joshajohnson/digital-explorer/README.md

Digital explorer board for common embedded protocols (UART, I2C, SPI, WS2812).

More info here: https://joshajohnson.com/digital-explorer-board/
