joshajohnson/digital-explorer/hardware/0.1/demo_pcb.pdf

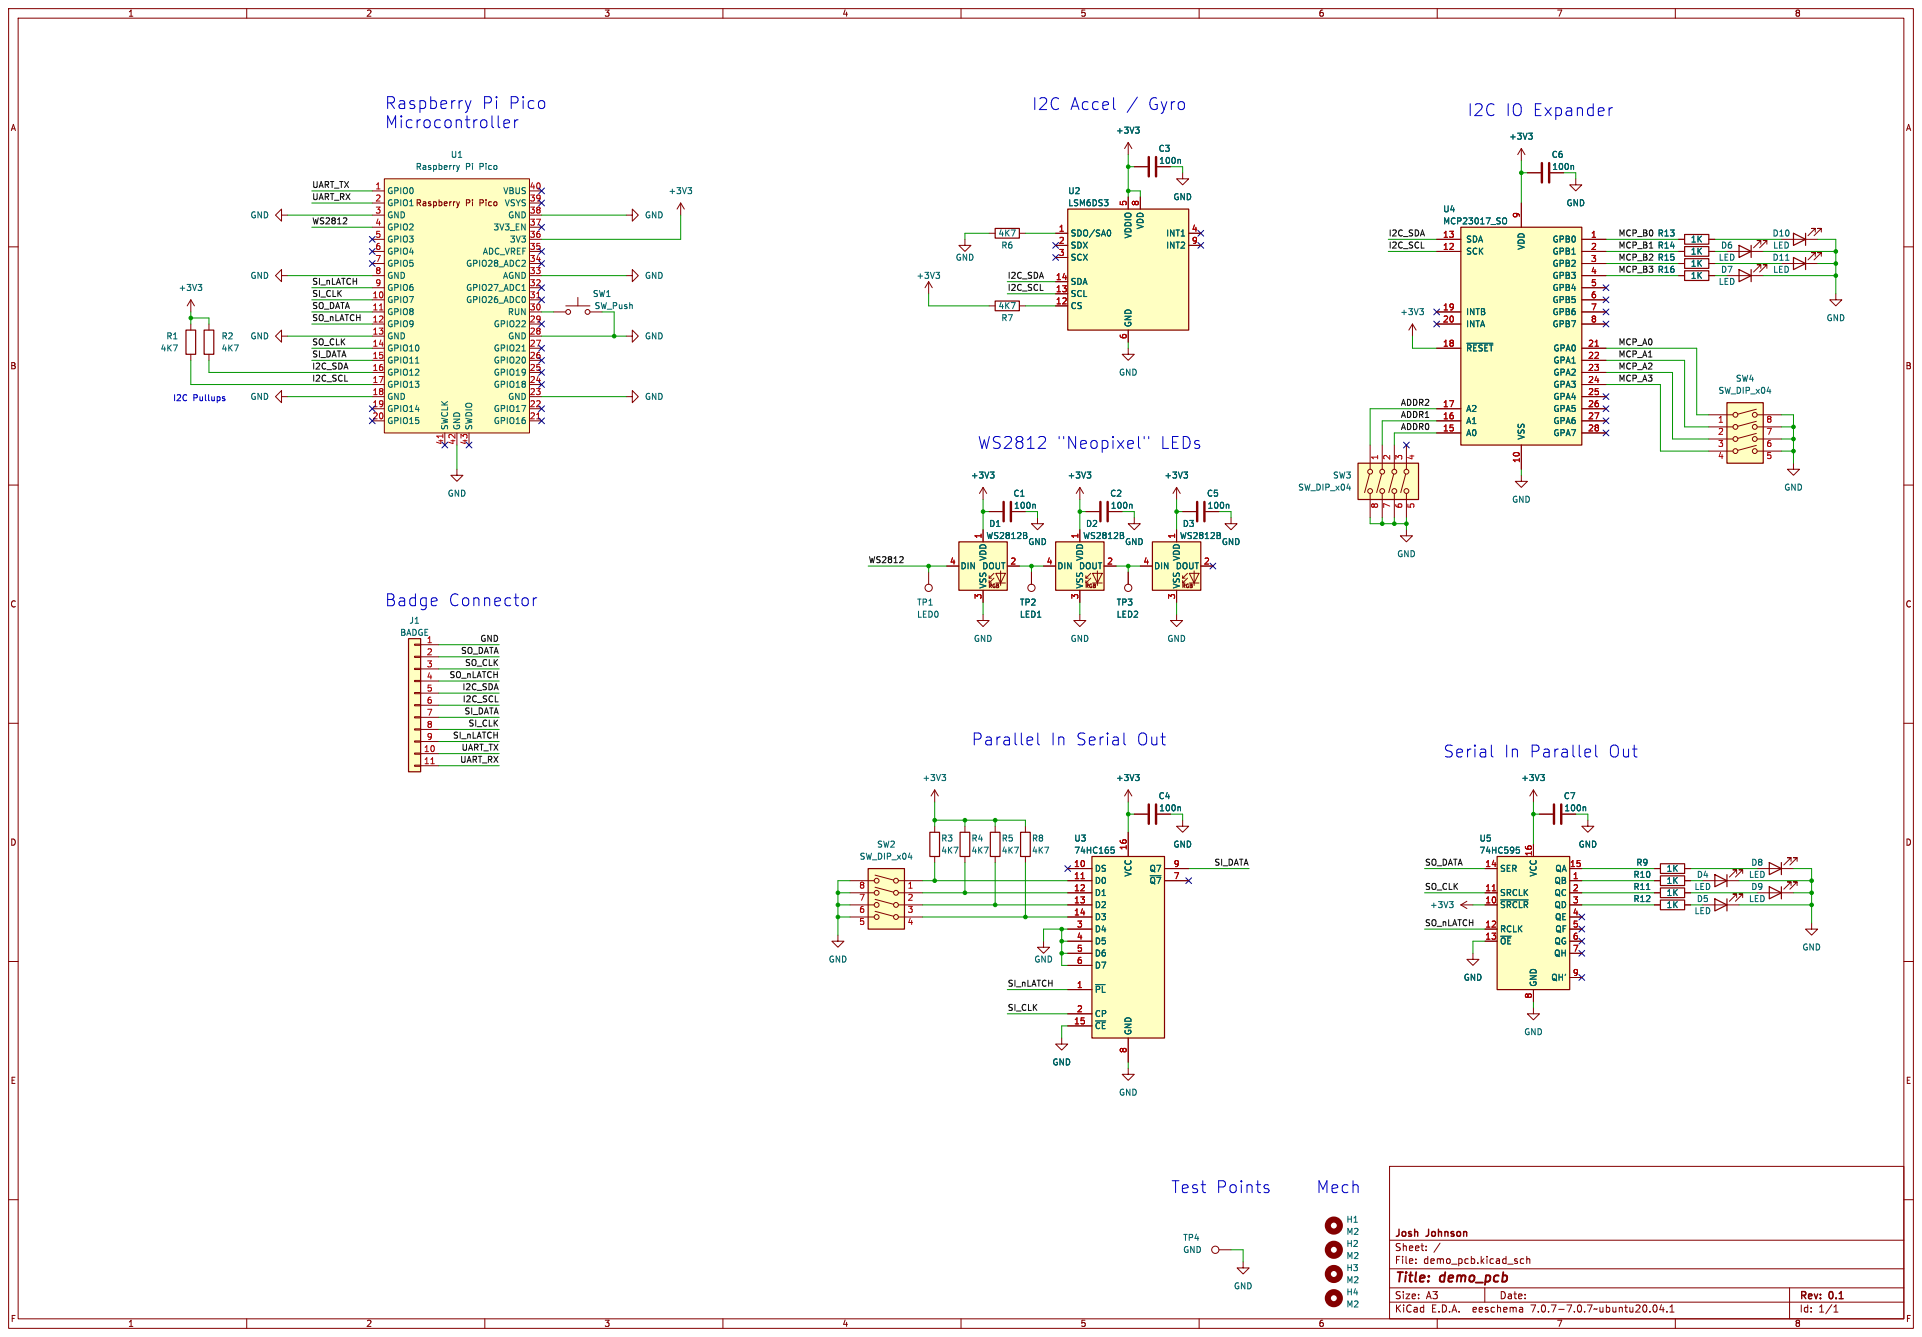
[picture p1: page 1]

LSM6DS3 SDO/SA0 1 CS 12 SCL 13 SDA 14 SDX 2 SCX 3

SDO/SA0 1 CS 12 SCL 13 SDA 14 SDX 2 SCX 3

File: demo_pcb.kicad_sch Sheet: / Josh Johnson
