joshajohnson/digital-explorer/hardware/0.1/demo_pcb.kicad_pcb

## KiCad design hardware/0.1/demo_pcb.kicad_pcb (2023-09-21)

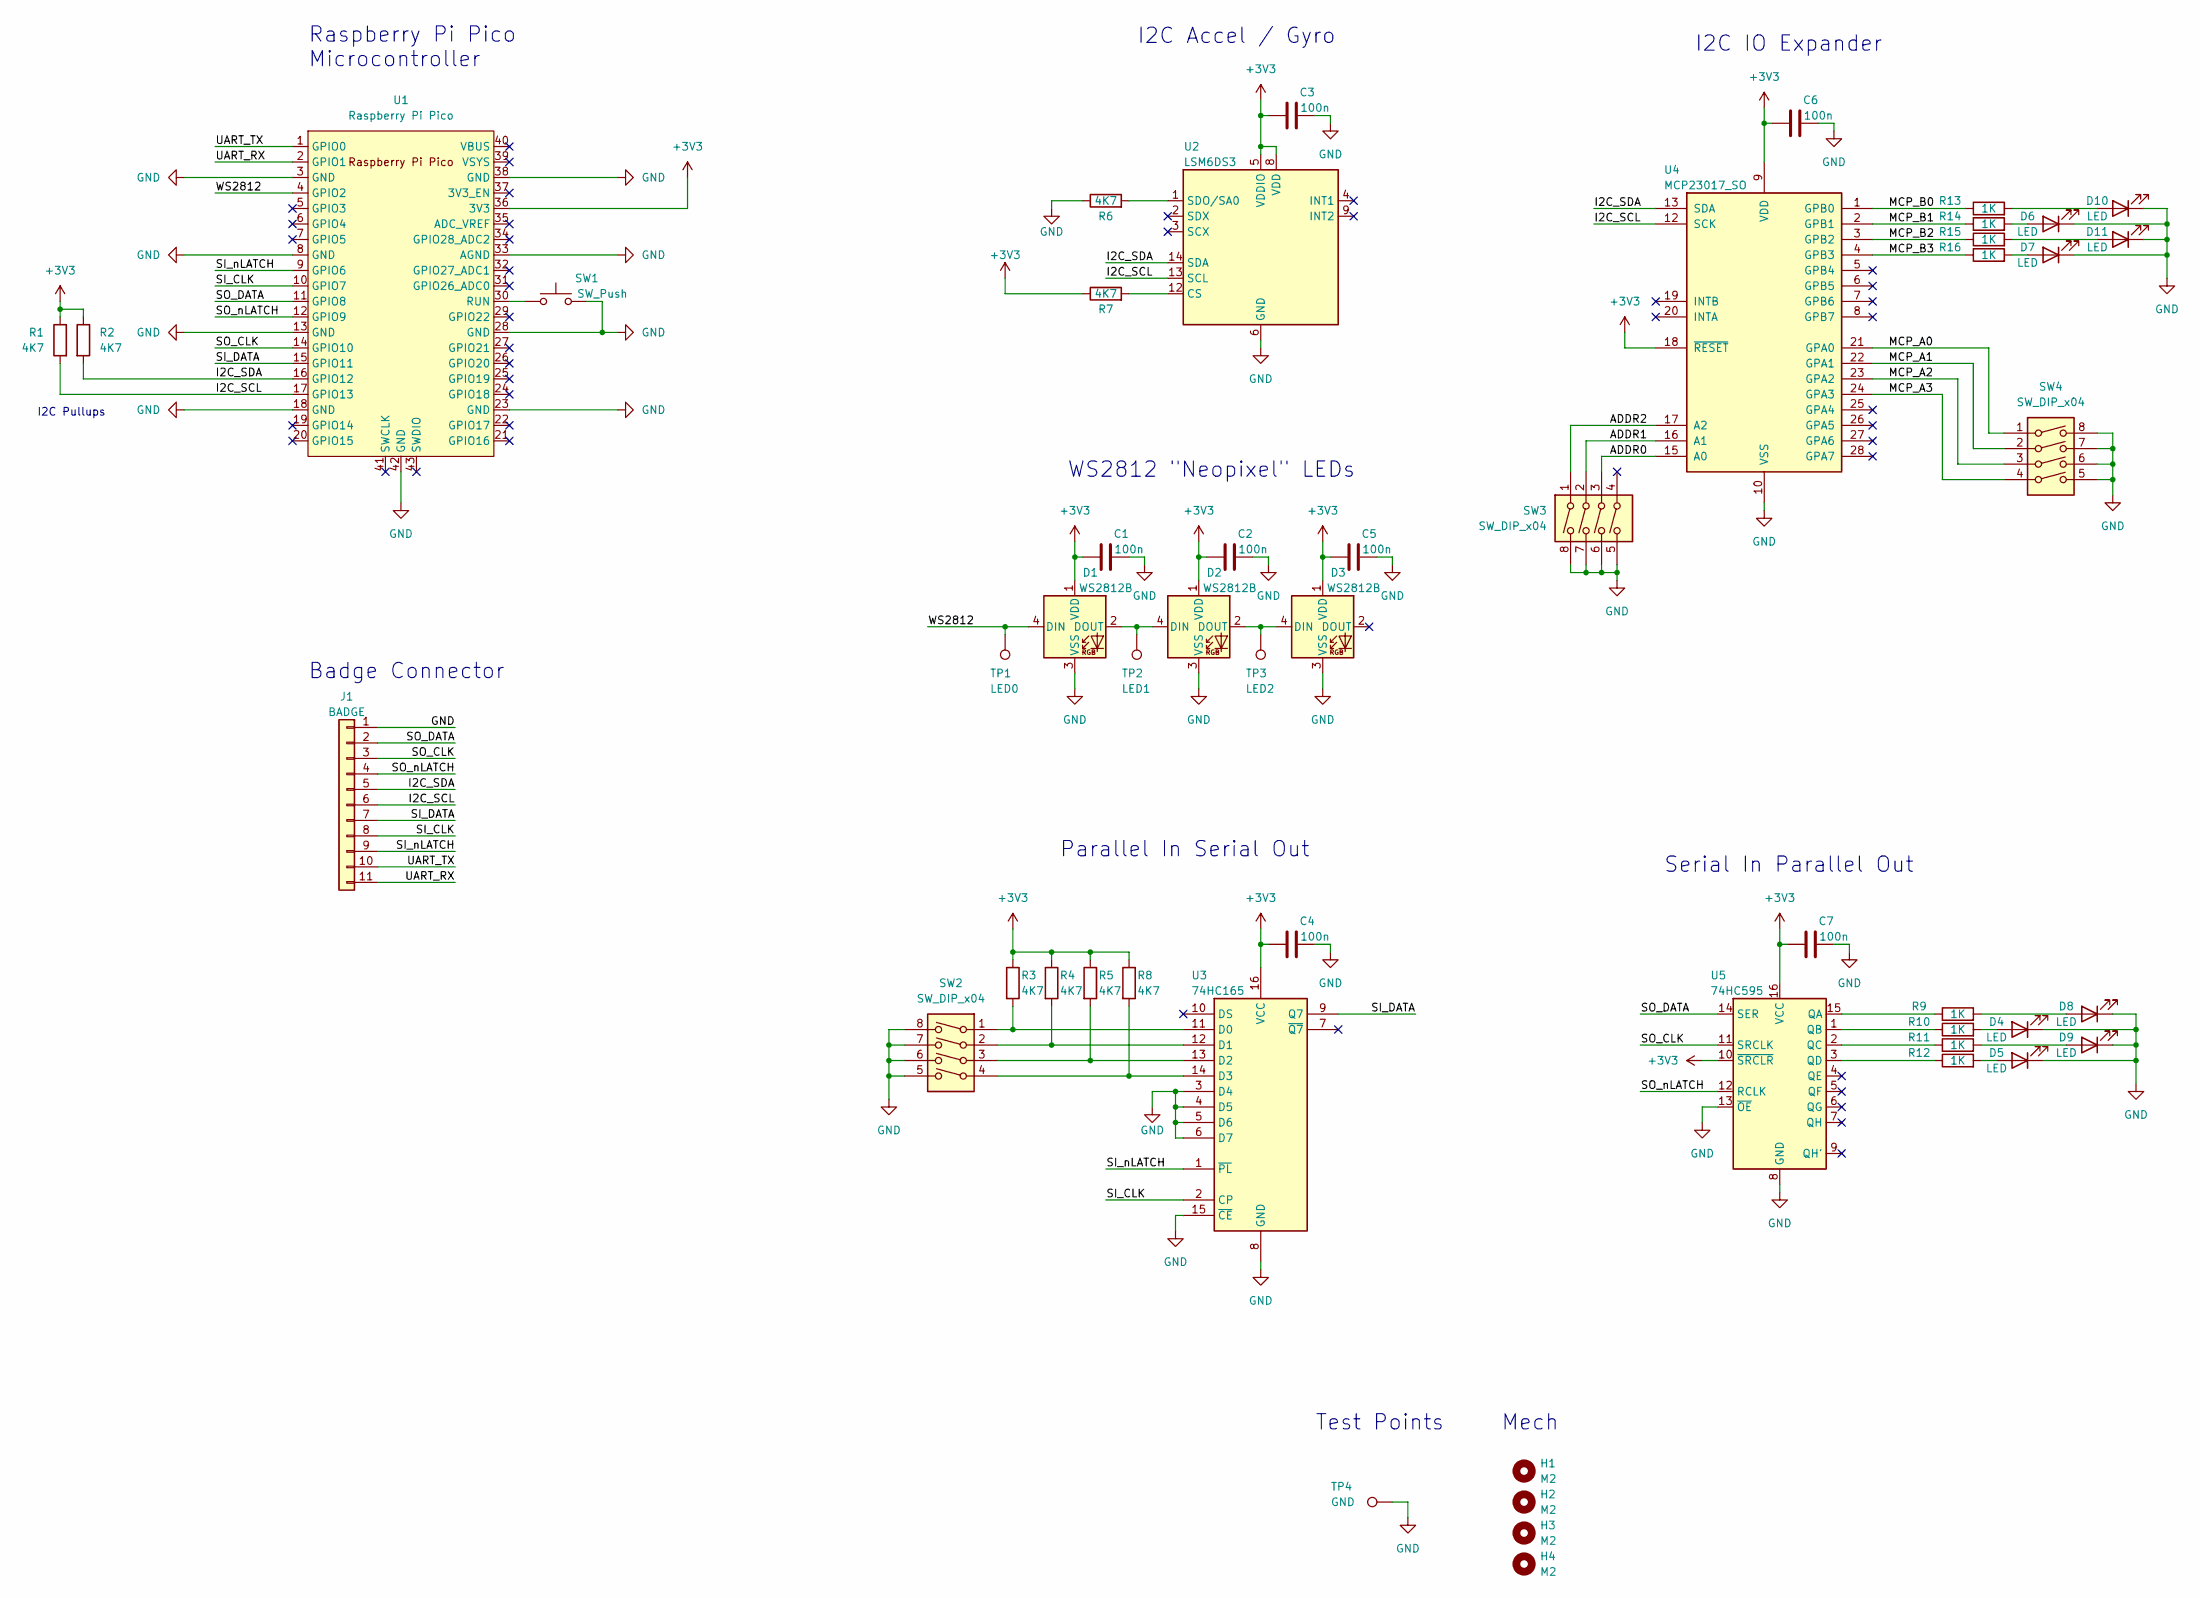
[picture p2: schematic demo_pcb.kicad_sch]

Parts:
C1, C2, C3, C4, C5, C6, C7: 100n; C_0603_1608Metric; LCSC C14663
D1, D2, D3: WS2812B; LED_WS2812B_PLCC4_5.0x5.0mm_P3.2mm
D4, D5, D6, D7, D8, D9, D10, D11: LED; LED_0603_1608Metric; LCSC C2286
H1, H2, H3, H4: M2; MountingHole_2.2mm_M2_DIN965_Pad
J1: BADGE; PinSocket_1x11_P2.54mm_Horizontal
R1, R2, R3, R4, R5, R6, R7, R8: 4K7; R_0603_1608Metric; LCSC C23162
R9, R10, R11, R12, R13, R14, R15, R16: 1K; R_0603_1608Metric; LCSC C21190
SW1: SW_Push; SW_SPST_PTS810
SW2, SW3, SW4: SW_DIP_x04; SW_DIP_SPSTx04_Slide_9.78x12.34mm_W7.62mm_P2.54mm; LCSC C99418
TP1: LED0; PinHeader_1x01_P2.54mm_Circle
TP2: LED1; PinHeader_1x01_P2.54mm_Circle
TP3: LED2; PinHeader_1x01_P2.54mm_Circle
TP4: GND; PinHeader_1x01_P2.54mm_Circle
U1: Raspberry Pi Pico; RPi_Pico_SMD_TH
U2: LSM6DS3; LGA-14_3x2.5mm_P0.5mm_LayoutBorder3x4y; LCSC C95230
U3: 74HC165; SO-16_3.9x9.9mm_P1.27mm; LCSC C5613
U4: MCP23017_SO; SOIC-28W_7.5x17.9mm_P1.27mm; LCSC C629440
U5: 74HC595; SO-16_3.9x9.9mm_P1.27mm; LCSC C5947

Connections:
+3V3: C1.1, C2.1, C3.1, C4.1, C5.1, C6.1, C7.1, D1.1 (VDD), D2.1 (VDD), D3.1 (VDD), R1.1, R2.1, R3.1, R4.1, R5.1, R7.1, R8.1, U1.36 (3V3), U2.5 (VDDIO), U2.8 (VDD), U3.16 (VCC), U4.9 (VDD), U4.18 (~RESET), U5.10 (~SRCLR), U5.16 (VCC)
/ADDR0: SW3.3, U4.15 (A0)
/ADDR1: SW3.2, U4.16 (A1)
/ADDR2: SW3.1, U4.17 (A2)
/I2C_SCL: J1.6, R1.2, U1.17 (GPIO13), U2.13 (SCL), U4.12 (SCK)
/I2C_SDA: J1.5, R2.2, U1.16 (GPIO12), U2.14 (SDA), U4.13 (SDA)
/MCP_A0: SW4.1, U4.21 (GPA0)
/MCP_A1: SW4.2, U4.22 (GPA1)
/MCP_A2: SW4.3, U4.23 (GPA2)
/MCP_A3: SW4.4, U4.24 (GPA3)
/MCP_B0: R13.1, U4.1 (GPB0)
/MCP_B1: R14.1, U4.2 (GPB1)
/MCP_B2: R15.1, U4.3 (GPB2)
/MCP_B3: R16.1, U4.4 (GPB3)
/SI_CLK: J1.8, U1.10 (GPIO7), U3.2 (CP)
/SI_DATA: J1.7, U1.15 (GPIO11), U3.9 (Q7)
/SI_nLATCH: J1.9, U1.9 (GPIO6), U3.1 (~PL)
/SO_CLK: J1.3, U1.14 (GPIO10), U5.11 (SRCLK)
/SO_DATA: J1.2, U1.11 (GPIO8), U5.14 (SER)
/SO_nLATCH: J1.4, U1.12 (GPIO9), U5.12 (RCLK)
/UART_RX: J1.11, U1.2 (GPIO1)
/UART_TX: J1.10, U1.1 (GPIO0)
/WS2812: D1.4 (DIN), TP1.1, U1.4 (GPIO2)
GND: C1.2, C2.2, C3.2, C4.2, C5.2, C6.2, C7.2, D1.3 (VSS), D2.3 (VSS), D3.3 (VSS), D4.1 (K), D5.1 (K), D6.1 (K), D7.1 (K), D8.1 (K), D9.1 (K), D10.1 (K), D11.1 (K), J1.1, R6.1, SW1.2, SW2.5, SW2.6, SW2.7, SW2.8, SW3.5, SW3.6, SW3.7, SW3.8, SW4.5, SW4.6, SW4.7, SW4.8, TP4.1, U1.3 (GND), U1.8 (GND), U1.13 (GND), U1.18 (GND), U1.23 (GND), U1.28 (GND), U1.33 (AGND), U1.38 (GND), U1.42 (GND), U2.6 (GND), U2.7 (GND), U3.3 (D4), U3.4 (D5), U3.5 (D6), U3.6 (D7), U3.8 (GND), U3.15 (~CE), U4.10 (VSS), U5.8 (GND), U5.13 (~OE)
unnamed: D1.2 (DOUT), D2.4 (DIN), TP2.1
unnamed: D2.2 (DOUT), D3.4 (DIN), TP3.1
unnamed: D4.2 (A), R10.2
unnamed: D5.2 (A), R12.2
unnamed: D6.2 (A), R14.2
unnamed: D7.2 (A), R16.2
unnamed: D8.2 (A), R9.2
unnamed: D9.2 (A), R11.2
unnamed: D10.2 (A), R13.2
unnamed: D11.2 (A), R15.2
unnamed: SW1.1, U1.30 (RUN)
unnamed: R7.2, U2.12 (CS)
unnamed: R6.2, U2.1 (SDO/SA0)
unnamed: R3.2, SW2.1, U3.11 (D0)
unnamed: R4.2, SW2.2, U3.12 (D1)
unnamed: R5.2, SW2.3, U3.13 (D2)
unnamed: R8.2, SW2.4, U3.14 (D3)
unnamed: R9.1, U5.15 (QA)
unnamed: R10.1, U5.1 (QB)
unnamed: R11.1, U5.2 (QC)
unnamed: R12.1, U5.3 (QD)

Notes on the sheet:
Badge Connector
I2C IO Expander
Parallel In Serial Out
Raspberry Pi Pico Microcontroller
I2C Pullups
WS2812 "Neopixel" LEDs
Test Points
Mech
I2C Accel / Gyro
Serial In Parallel Out

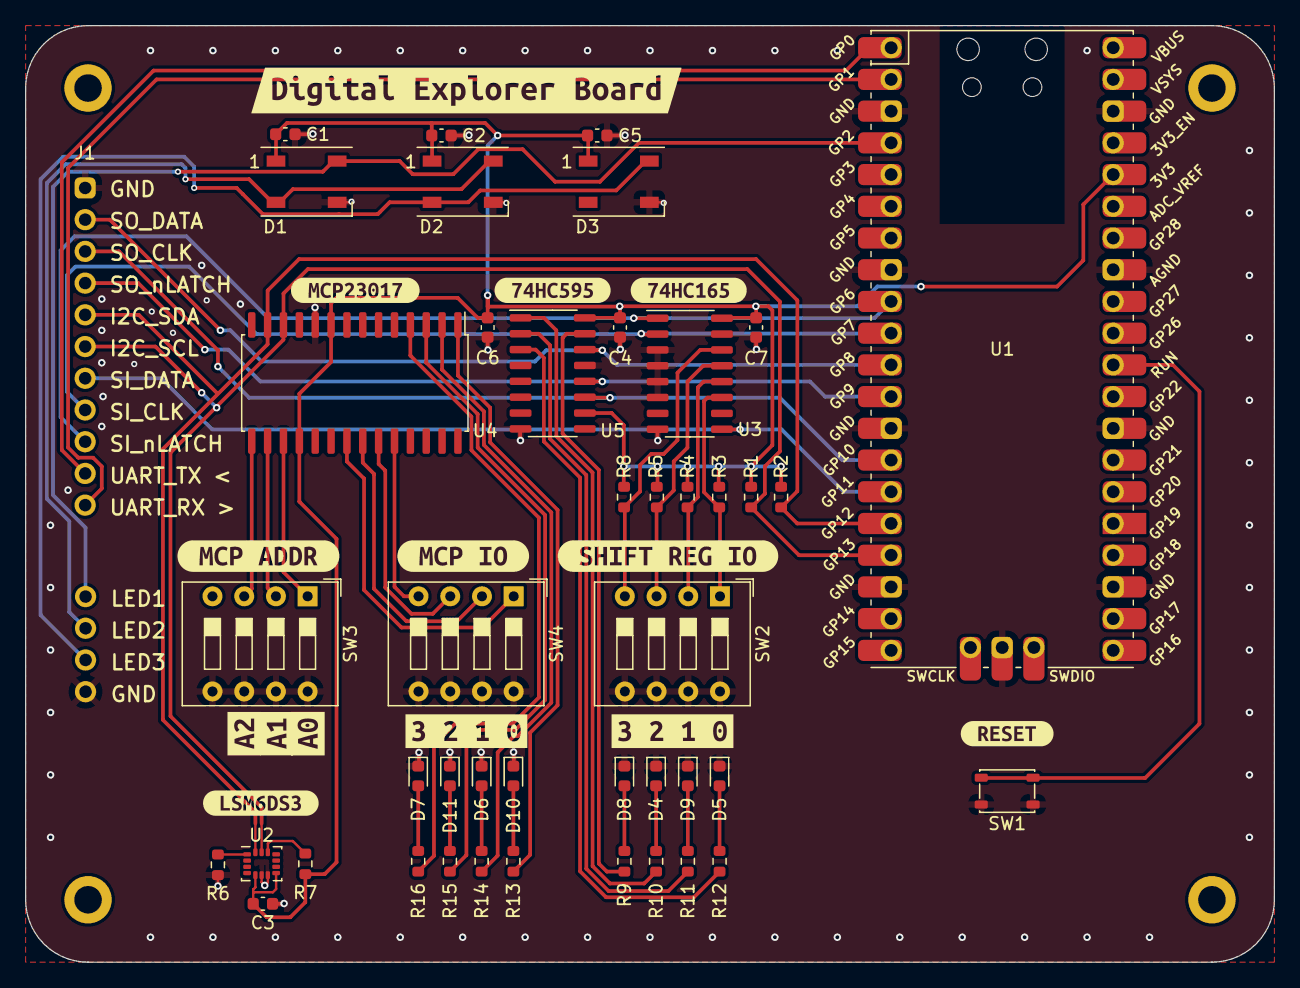
[picture p3: board demo_pcb.kicad_pcb from above]

Board: 2 copper layers, 100.0 x 75.0 mm, 66 parts (0 on the bottom side), 45 nets.

Other parts of the board:
kibuzzard-64BE6A65: G***; kibuzzard-64BE6A65
kibuzzard-64BE6A90: G***; kibuzzard-64BE6A90
kibuzzard-64BE68F6: G***; kibuzzard-64BE68F6
kibuzzard-64BE673E, kibuzzard-64BE673E#2: G***; kibuzzard-64BE673E
kibuzzard-64BE676D: G***; kibuzzard-64BE676D
kibuzzard-64BE679E: G***; kibuzzard-64BE679E
kibuzzard-64BE6544: G***; kibuzzard-64BE6544
kibuzzard-64BE6560: G***; kibuzzard-64BE6560
kibuzzard-64BE6573: G***; kibuzzard-64BE6573
kibuzzard-64BE6790: G***; kibuzzard-64BE6790
kibuzzard-64BE6934: G***; kibuzzard-64BE6934
kibuzzard-64BE6949: G***; kibuzzard-64BE6949
kibuzzard-64BFA375: G***; kibuzzard-64BFA375
