joshajohnson/digital-explorer/(commit log)

2023-09-21 add kicad files
    [demo_pcb.kicad_pcb, demo_pcb.kicad_sch]
2023-09-21 add rpi pico software
2023-09-23 add \r\n to uart
